DKR-HIPS/downtimer/(commit log)

2022-02-06 Add files via upload
    Wiring scheme for the DownTimer electronics
2022-02-11 Update DownTimer.ino
    fixed a bug with calculation of bonus time
    [DownTimer.ino]
